james-ze/lab2-mi-primer-diseno/docs/conexiones_fpga.png

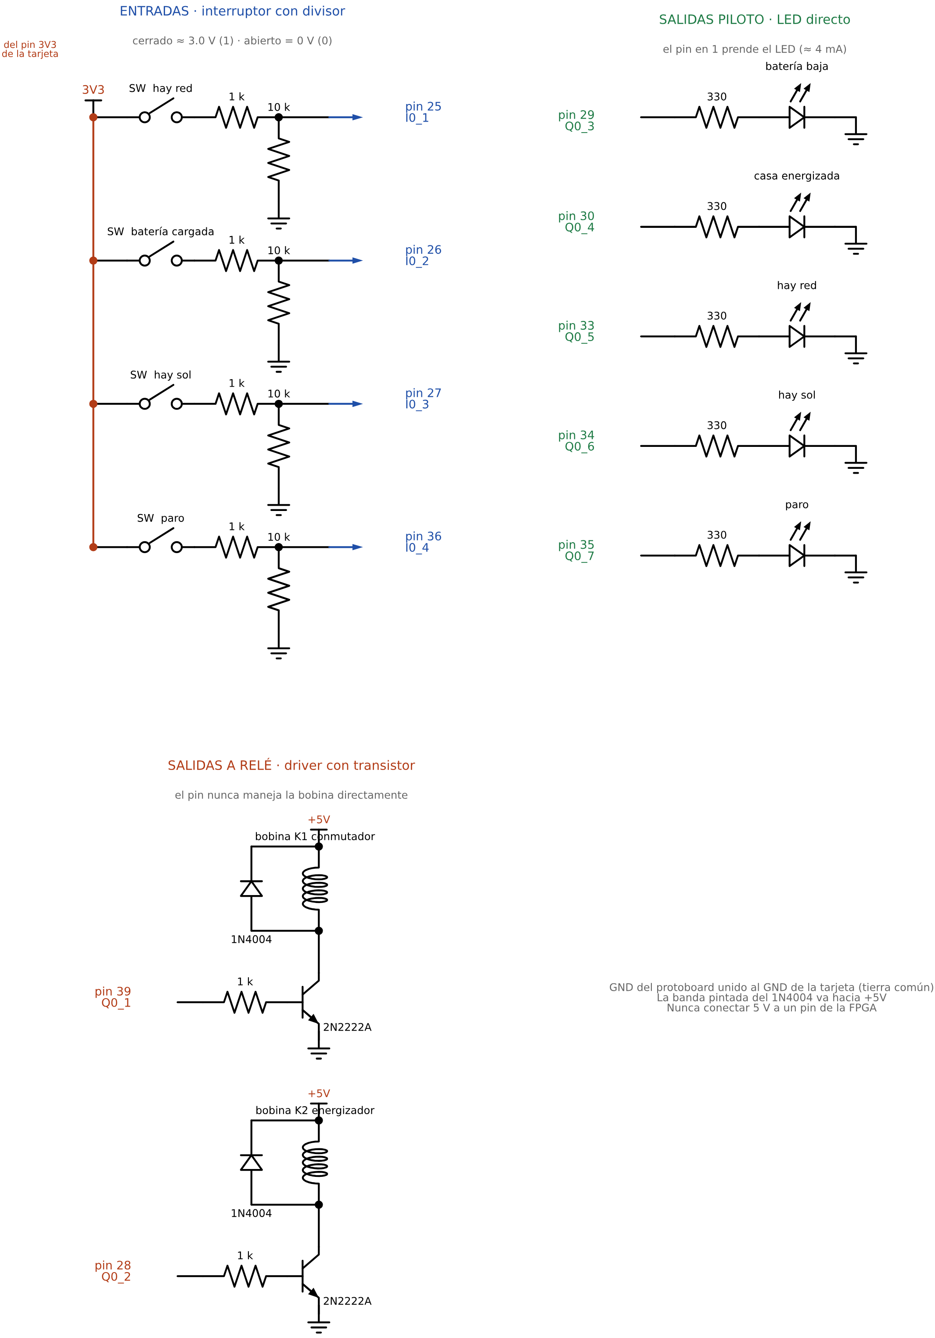
docs/conexiones_fpga.png
