james-ze/lab2-mi-primer-diseno/docs/protoboard.png

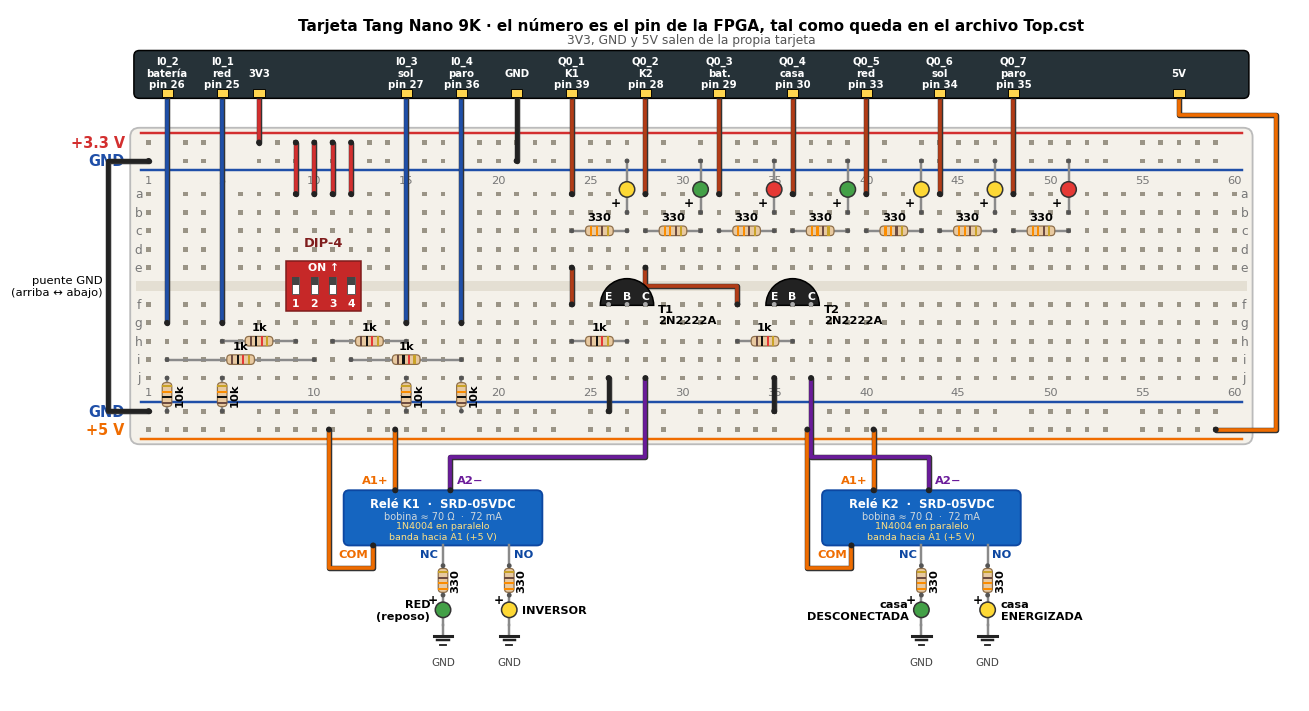
docs/protoboard.png
