james-ze/lab2-mi-primer-diseno/docs/rele.png

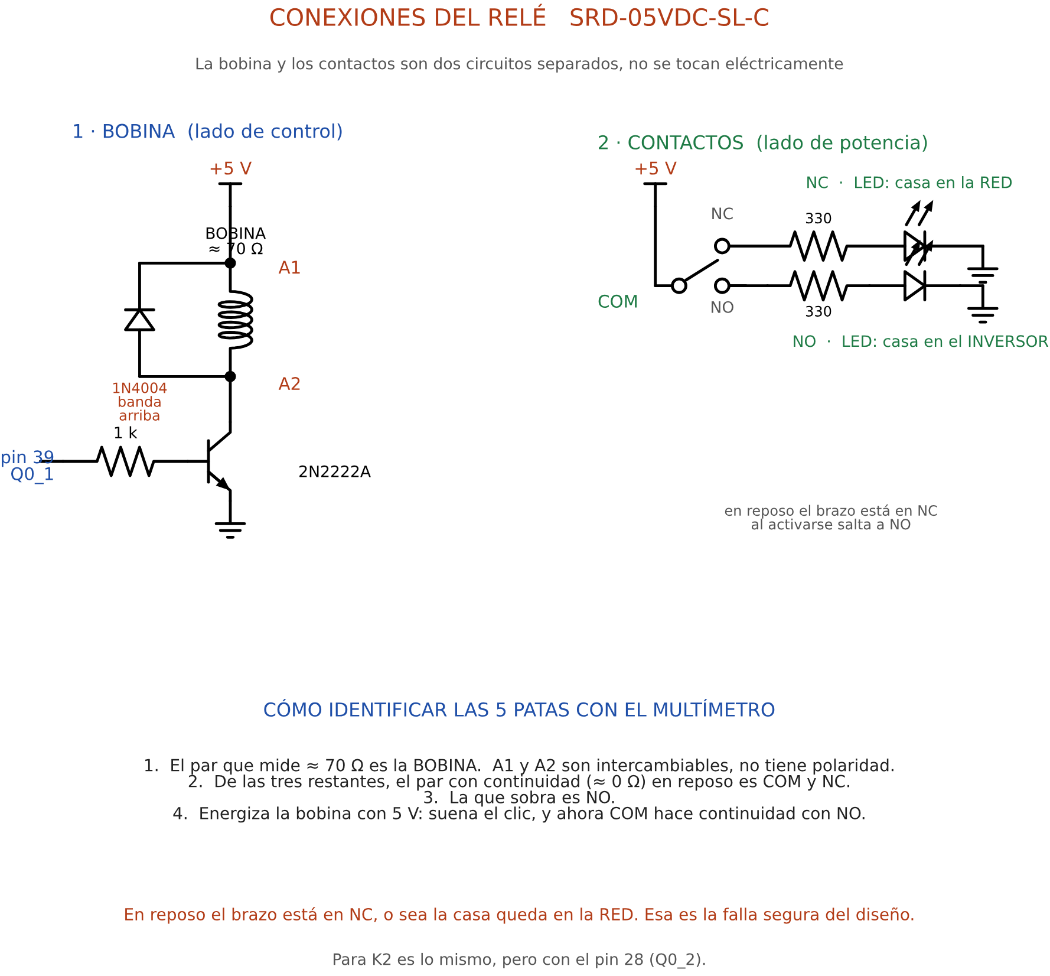
docs/rele.png
