james-ze/lab2-mi-primer-diseno/docs/top.png

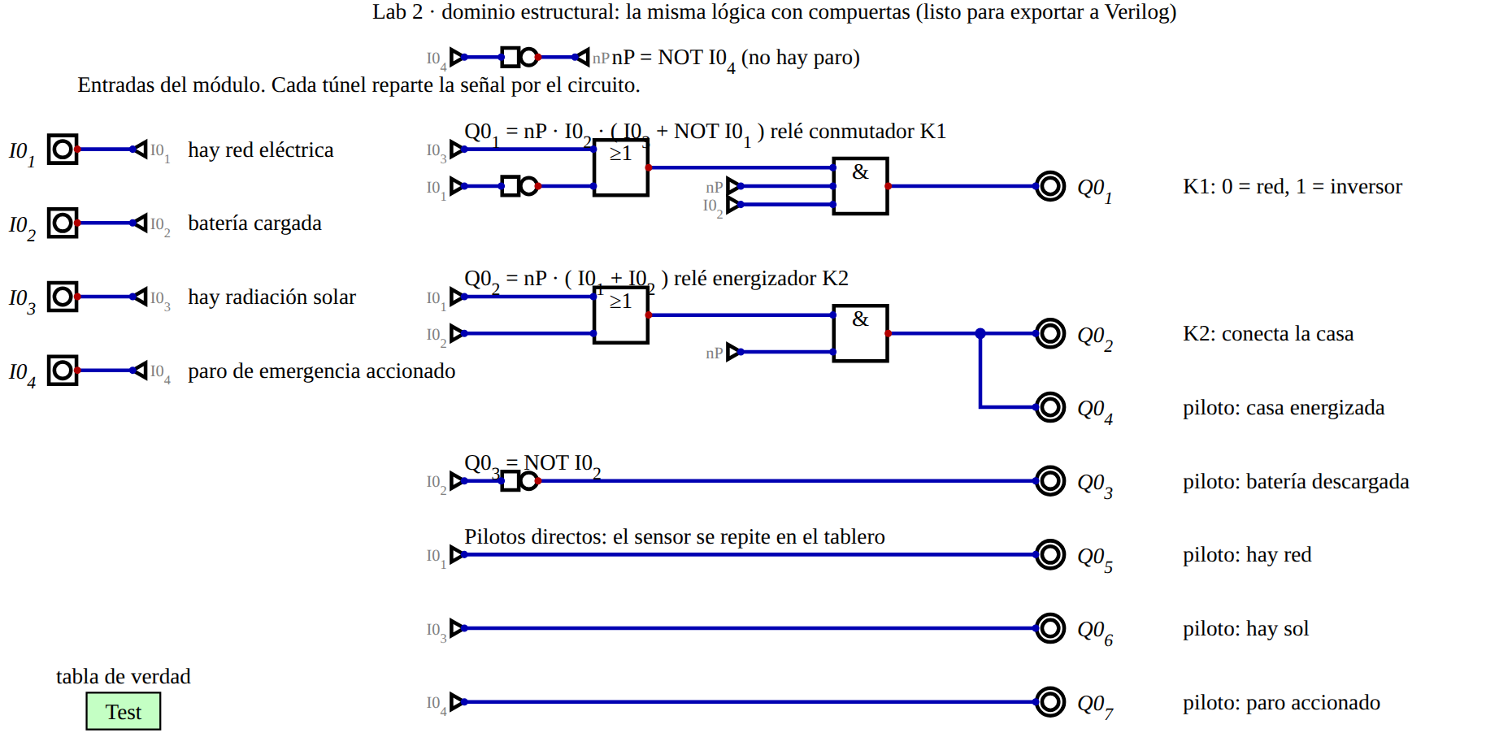
docs/top.png
