james-ze/lab2-mi-primer-diseno/simulacion/onda_simulacion.png

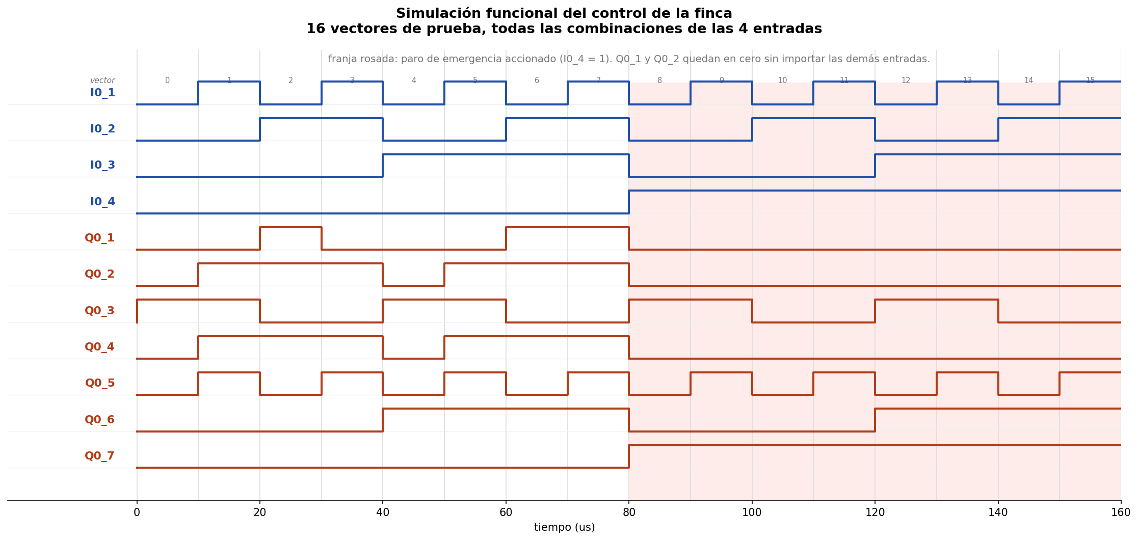
simulacion/onda_simulacion.png
