james-ze/lab2-mi-primer-diseno/(commit log)

2026-10-06 Agrega el diseno del sistema: circuito de contactos, compuertas y testbench
    El dominio fisico usa reles y no es sintetizable. El dominio estructural
    en compuertas es el que se exporta a Verilog. El testbench verifica las
    16 combinaciones posibles de las 4 entradas.
2026-10-06 Agrega el top y el archivo de pines para la Tang Nano 9K
    top.v instancia control_finca y expone los puertos fisicos. top.cst
    asigna los once pines, con las entradas en pines verificados a 3.3V
    porque una entrada mal ubicada puede danar el chip.
2026-10-06 Agrega figuras del montaje y del circuito estructural
    Vista de protoboard con la asignacion de pines, conexiones del rele
    con el metodo de identificacion de patas, esquematico por etapas y
    circuito de compuertas exportado de Digital.
2026-10-06 Escribe el README con el criterio de diseno y los pasos para reproducir
    Documenta la eleccion de prioridad solar, la falla segura por contacto NC,
    la asignacion de pines y las limitaciones conocidas del montaje.
2026-10-06 Completa la lista de integrantes del grupo en el README
2026-10-06 Agrega la evidencia de la etapa de simulacion
    Volcado VCD de los 16 vectores, figura de la forma de onda y notas con
    el analisis. Se incluye plot_vcd.py, el script que genera la figura a
    partir del VCD, para que el resultado sea reproducible.
2026-10-06 Habilita el volcado VCD en el testbench y agrega .gitignore
    El testbench exportado por Digital no incluye dumpfile ni dumpvars, asi
    que la simulacion corria pero no dejaba archivo. Se ignoran los archivos
    que se regeneran; el bitstream top.fs si se versiona porque es evidencia.
